Elipos47/robocup-2027-hand-on/hardware/README.md

# Hardware

Questa directory è riservata allo schema elettrico, cablaggi, misure e note di montaggio.

Non contiene ancora codice o file CAD. Il riferimento CAD esterno e le misure da eseguire sono
descritti in `docs/hardware/CAD_REFERENCE.md` e `docs/MEASUREMENT_LOG.md`.
