Elipos47/robocup-2027-hand-on/docs/hardware/checkerboard-a4.pdf

Checkerboard 9x6 corner interni, quadrato 25 mm - stampare al 100% 100 mm
