Elipos47/robocup-2027-hand-on/docs/hardware/Misure Robotica.pdf

INGOMBRI : la*lu*alt
Telecamera nera
Telecamera verde
Servo
Motori
Luci
Schermo
Batterie: 55x67x46

Arduino: 53x108x15 M3

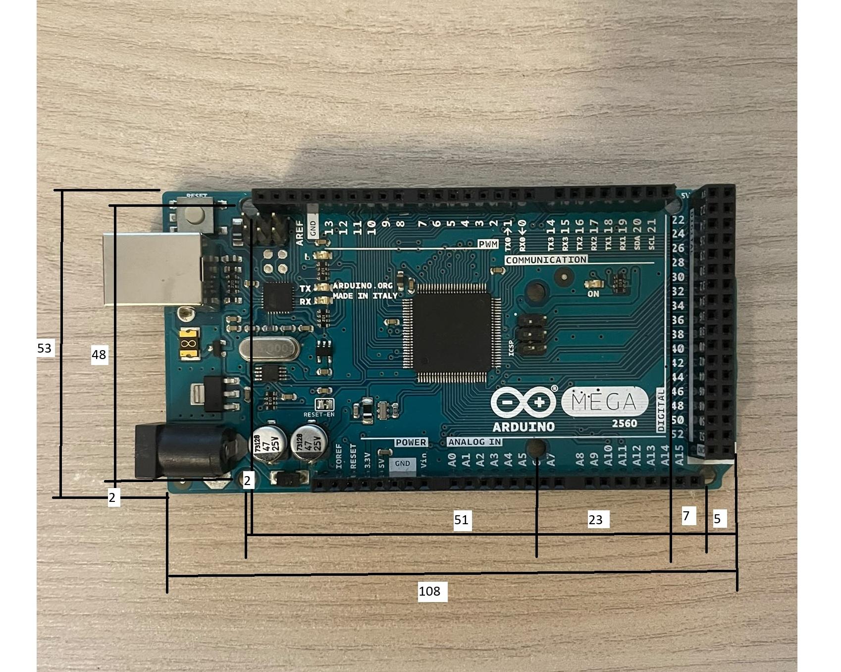
[picture p1: figure]

Raspberry :57x90x20 M3

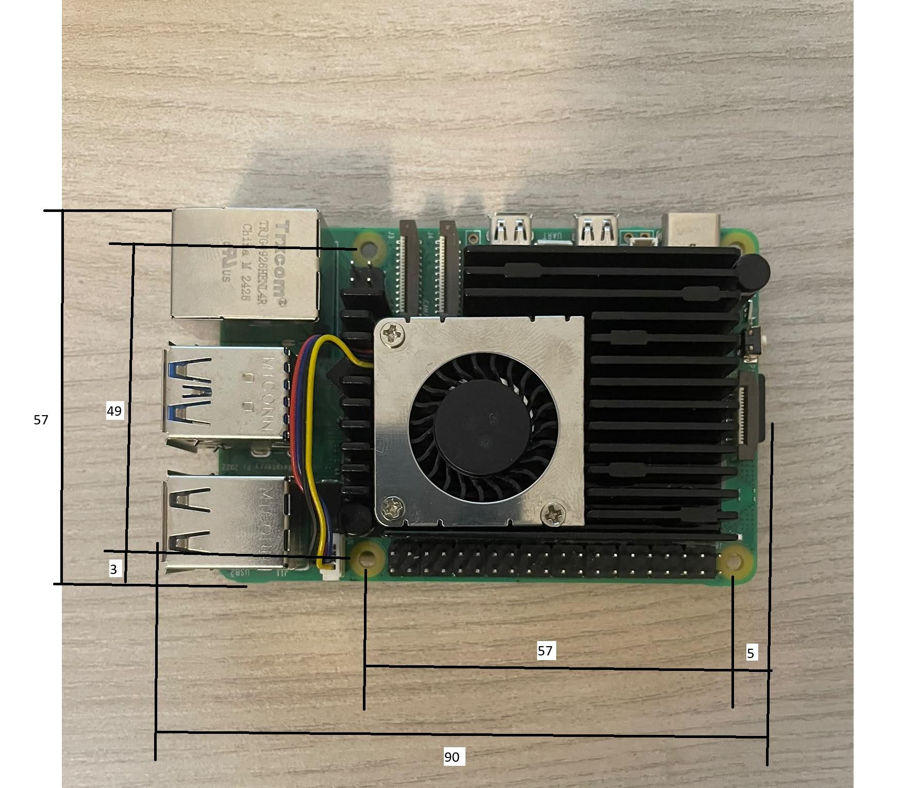
[picture p2: figure]

UPS: 71x90x35 M3

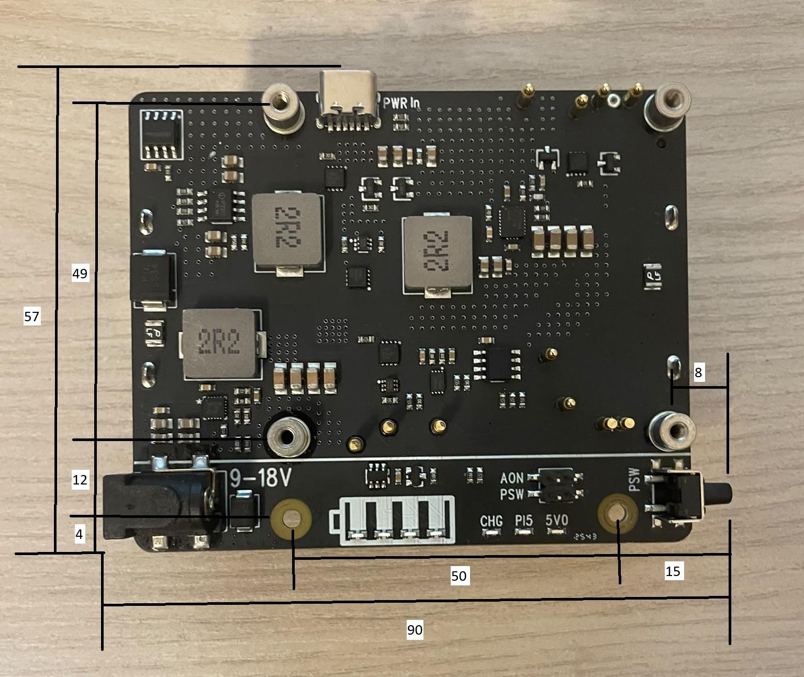
[picture p3: figure]

Sensore distanza: 6+20x45x15 M1

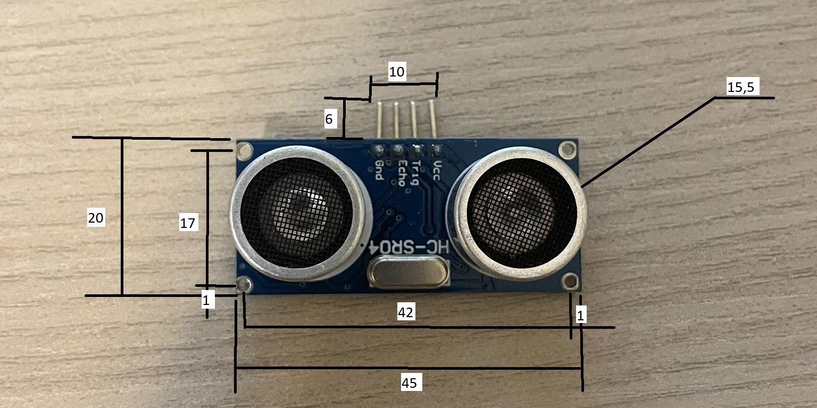
[picture p4: figure]

Giroscopio: 23x25x12 M2

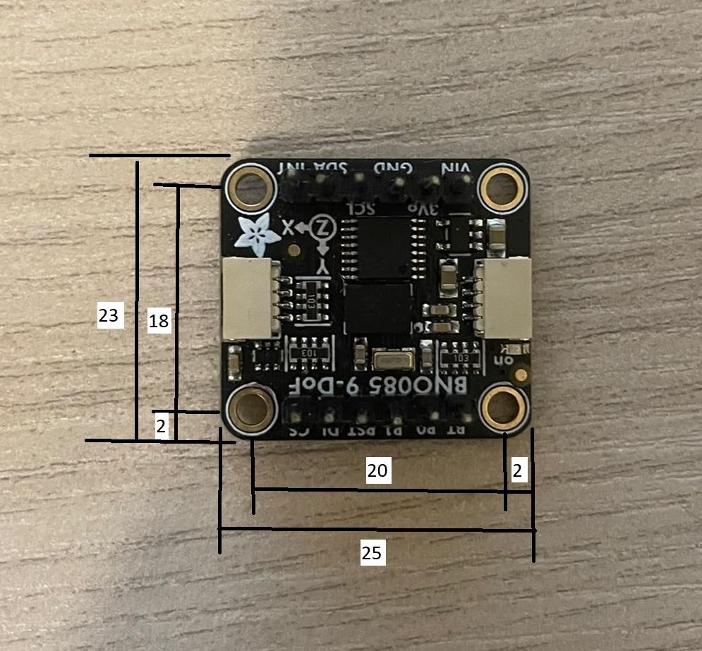
[picture p5: figure]
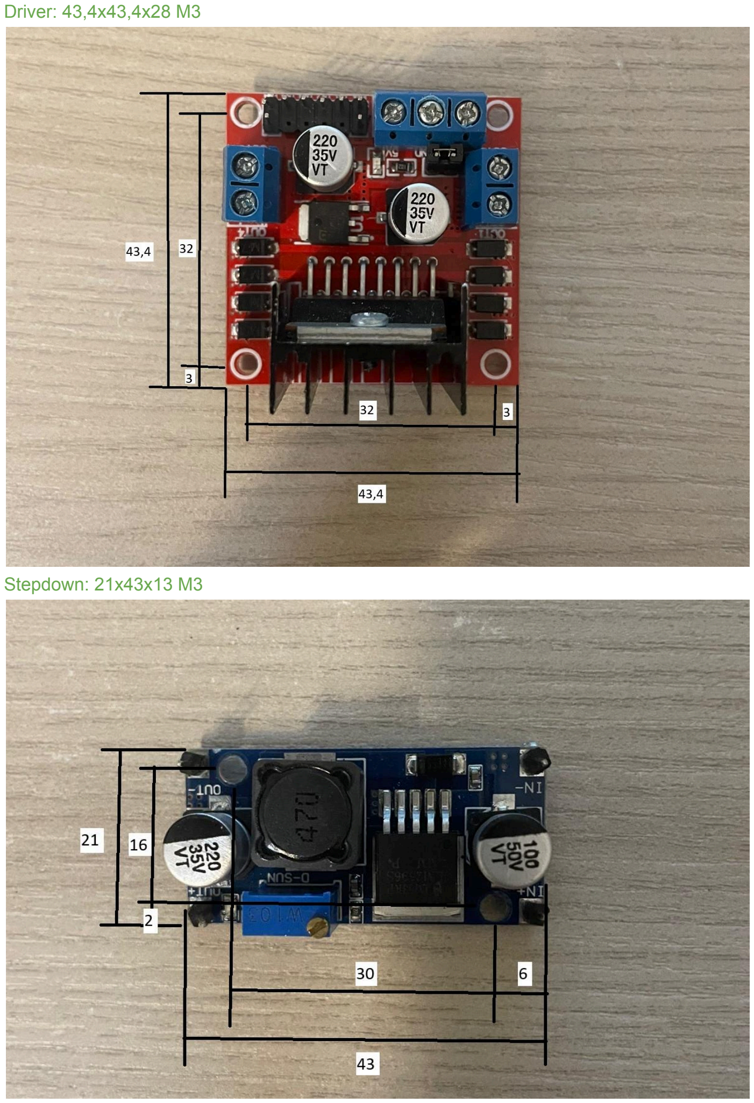
[picture p6: page 6]

Driver: 43,4x43,4x28 M3

Stepdown: 21x43x13 M3

FEATURE NECESSARIE/DA TENERE CONTO Maniglia
Interruttore
Cavo arduino
Cavo luci
Cavo telecamera verde
Cavo telecamera nera

COLLEGAMENTI
Telecamera nera = Raspberry Telecamera verde = Raspberry
UPS = Sotto raspberry
Raspberry = UPS+Arduino+Schermo Arduino = raspberry
Schermo = Raspberry
Servo = Arduino+Stepdown
Motori = L298
Luci = raspberry
Batterie = stepdown+L298
Giroscopio = arduino
Sensore distanza = Arduino Stepdown = batterie+servomotori L298 = Arduino+batterie
