Elipos47/robocup-2027-hand-on/docs/testing/MOTOR_POWER_DIAGNOSTIC.md

# Diagnosi alimentazione motori

**ID:** F0-5 / PWM-DIAG-1
**Data:** 2026-11-04
**Contesto:** due run del test a coppia 255
(`software/logs/pwm-pair-repeat-001.jsonl`, `software/logs/pwm-pair-repeat-002.jsonl`).
**Stato:** seconda run eseguita con multimetro; alimentazione stabile, misura A da solo 3 V e
A+B 0-1 V. Confronto con l'archivio fatto: mappa pin diversa, da verificare sul cablaggio
prima di cambiare i cavi.
**Obiettivo:** isolare la causa del guasto sotto carico prima di riprendere le misure di PWM
minimo e cm/s.

## Sintomo osservato

- prima fase avanti (255 su entrambe le ruote): entrambe le ruote girano;
- prima fase indietro (-255): la ruota destra non gira;
- fasi successive: entrambe le ruote fanno uno scatto iniziale e poi si fermano.

Il software ha accettato tutti i 6 comandi (`ack` 6-7 ms), lo status riporta `motors_active`
per tutta la durata e gli stop hanno ricevuto ack. Il firmware non ha segnalato errori o
watchdog. Il guasto e' quindi a valle dei pin del Mega: alimentazione, L298N, connettori o
motori.

## Risultati delle due run

| Run | Condizione | Esito fisico | Tensione +12/GND L298N |
|---|---|---|---|
| `pwm-pair-repeat-001` | robot appoggiato al tavolo, sotto carico | prima avanti ok, poi ruota destra ferma e scatti | non misurata |
| `pwm-pair-repeat-002` | ruote sollevate, multimetro DC | stesso guasto | stabile 10-12 V per tutta la prova |

La tensione stabile esclude batteria, BMS e caduta sul collegamento di alimentazione come causa
primaria. Restano il L298N (canale A o protezione termica), il motore destro e i connettori.
La prossima prova utile e' il test dei canali separati con misura di `OUT1`/`OUT2` e
`OUT3`/`OUT4` durante A avanti, A indietro, B avanti e B indietro, piu' la temperatura del
L298N.

## Misura con `pwm_staggered_test` (2026-11-04)

- A da solo a 255: **3 V** ai capi di `OUT1`/`OUT2`, motore A gira lentamente;
- A+B insieme: **0-1 V** ai capi di `OUT1`/`OUT2`, motore A fermo o solo scatto;
- multimetro in DC, puntali su `OUT1`/`OUT2`, ruote sollevate.

3 V sono troppo pochi: con alimentazione 10-12 V e la caduta tipica dell'L298N il motore
dovrebbe vedere circa 7-9 V. Il calo a 0-1 V quando si aggiunge B indica un limite condiviso:
alimentazione, massa o protezione termica. Poiche' `+12`/`GND` era stabile, i candidati
principali sono il **canale A del L298N** (caduta interna o protezione) e il **motore A**
(assorbimento anomalo per attrito o corto).

Misure successive, in ordine:

1. `5V` dell'Arduino rispetto a `GND`, a riposo e durante A da solo: atteso ~5 V;
2. `ENA` rispetto a `GND` durante A da solo: atteso ~5 V a 255;
3. temperatura del L298N dopo A da solo: se molto caldo, e' protezione termica;
4. scambio dei due connettori motore su `OUT1`/`OUT2` e `OUT3`/`OUT4`, a motori spenti e con
   approvazione: se il guasto segue il motore A e' il motore, se resta sul canale A e' l'L298N.

## Alimentazione motori assente (2026-11-05)

La batteria era collegata al morsetto `5V` del L298N invece che a `+12`. Il morsetto
`5V` e' l'uscita del 7805 (con jumper inserito) oppure l'ingresso del rail logico
(con jumper rimosso): non e' un ingresso di potenza. Con 11,1 V su quel morsetto il
rail logico e' fuori specifica (L298N `Vss` massimo 7 V) e i motori non avevano la
supply `Vs`. La lettura di 10-12 V su `+12` fatta in precedenza non dimostra che il
morsetto fosse alimentato: puo' essere la tensione di ritorno attraverso il 7805,
che sotto carico crolla. Le uscite OUT1=4 V, OUT2=0,8 V, OUT3=3 V, OUT4=0,6 V sono
coerenti con questo errore, non con due canali del ponte guasti. Il modulo non si e'
bruciato perche' la corrente era limitata dal percorso del 7805 e dal carico della
logica; resta fuori specifica e va considerato sospetto.

Da fare: ricollegare batteria `+` a `+12` e batteria `-` a `GND`, verificare il
jumper `5V`, controllare i rail 5 V di L298N, Arduino e Raspberry, poi ripetere
`pwm_a_forward_test` e misurare di nuovo.

## Ponte verificato a banco (2026-11-05)

Con `+12` alimentato e il `5V` del L298N collegato direttamente a `IN1` (bridge
chiuso a mano, senza PWM), il motore A gira. Quindi il 7805, il ponte e il motore
sono sani; il mancato movimento dopo il ricablaggio era un problema di connessioni
(segnale, GND o alimentazione logica). Resta da verificare il percorso
Arduino -> `ENA`/`IN1`/`IN2` con `pwm_a_forward_test` e la PWM.

## Confronto con il codice 2025-2026

| Progetto | EN destra (A) | IN destra (A) | EN sinistra (B) | IN sinistra (B) | Note |
|---|---:|---|---:|---|---|
| Attuale `firmware/rcj2027` | 12 (`ENA`) | 22/23 | 13 (`ENB`) | 24/25 | PWM su 12/13, IN digitali |
| Archivio `Final/robo_arduino` | 45 | 25/26 | 44 | 23/24 | commento nel sorgente: 22-27 non sono PWM, enable spostati su 44/45 |
| Archivio `nogyro/robo_arduino` | 27 | 25/26 | 22 | 23/24 | usa `analogWrite` anche su 22/27, che non sono PWM |
| Archivio `Arduino.ino` | jumper | 2/3 | jumper | 4/5 | nessun pin enable pilotato |

La legge di comando e' la stessa: due pin di direzione per canale, enable PWM, stop con
`EN=0` e `IN` bassi. La differenza e' la **mappa dei pin**. Se il robot e' ancora cablato come
l'anno scorso, il firmware attuale pilota pin diversi e i sintomi osservati (un motore che va,
l'altro no, scatti, tensione bassa) sono attesi.

Prima di cambiare i cavi, verificare a motori spenti con il multimetro in continuita':

- `ENA`/`ENB`: sono su 12/13, su 44/45 o su 22/27?
- `IN1`..`IN4`: sono su 22-25 o su 23-26?
- i jumper `ENA`/`ENB` sul L298N sono presenti o rimossi?
- il jumper `5V` del L298N e' inserito e il suo 5V e' collegato al 5V dell'Arduino?

Se il cablaggio corrisponde alla mappa attuale, la legge di comando e' equivalente a quella
dell'anno scorso e il sospetto torna su cavi, connettori, L298N o motore. Se non corrisponde,
non serve cambiare i cavi: vanno spostati sui pin del firmware attuale, oppure va cambiata la
mappa nel firmware.

## Caduta sui cavi e sui morsetti

Un cavo molto grosso in un morsetto piccolo puo' essere serrato solo su poche trecce: la
resistenza di contatto sale e sotto carico si perde tensione. Non e' il diametro in se', e' la
superficie di contatto.

Prova:

1. A da solo a 255 per 3-5 s, ruote sollevate.
2. Misurare la tensione sui morsetti `OUT1`/`OUT2` del L298N e ai capi del motore.
3. Se la differenza e' maggiore di 0,5 V a 1-2 A, il cavo o il morsetto e' il problema.
4. A motori spenti, controllare continuita' e resistenza del cavo; muovere il cavo per cercare
   un'intermittenza.
5. Dopo la prova, toccare i morsetti: un contatto caldo e' un contatto resistivo.

Rimedio: capocorda a tubetto o un pigtail di 1,0-1,5 mm² crimpato, con guaina termorestringente;
non saldare a stagno il cavo nel morsetto. Il cavo va dimensionato per la corrente, non per il
diametro massimo del morsetto.

## Ipotesi

| # | Ipotesi | Come discriminare |
|---:|---|---|
| 1 | batteria scarica o BMS che limita la corrente | tensione ai morsetti a riposo e durante il comando; se crolla o il BMS stacca, e' l'alimentazione |
| 2 | L298N in protezione termica o sovracorrente | temperatura del modulo e durata prima dell'arresto; se riparte dopo raffreddamento, e' il ponte |
| 3 | connettore o GND intermittente | prova a ruote sollevate muovendo delicatamente i connettori; cercare cavi caldi o contatti allentati |
| 4 | semiconduttore del canale A (ruota destra) danneggiato | A avanti/indietro da solo; misurare OUT1/OUT2 e scambiare i motori solo con approvazione |
| 5 | motore o riduttore destro bloccato | ruota girata a mano con alimentazione staccata; corrente a vuoto del solo motore |

## Procedura

**Sicurezza:** ruote sollevate e robot fissato per tutte le prove elettriche. Nessun test a
terra finche' la causa non e' isolata. Non cambiare cablaggi senza approvazione.

1. **Ispezione a motori spenti**
   - ruote girate a mano: devono girare libere;
   - connettori ENA/ENB, IN1..IN4, OUT1..OUT4 e GND ben inseriti;
   - nessun cavo caldo, spellato o connettore sciolto.

2. **Misure a riposo e sotto carico**
   - tensione batteria ai morsetti;
   - tensione +12 V e +5 V sul L298N;
   - tensione durante un comando a 255 (ruote sollevate);
   - temperatura del L298N prima e dopo 3 s a 255.
   Registrare i valori in `docs/MEASUREMENT_LOG.md`.

3. **Canali separati a ruote sollevate**
   - caricare `firmware/test/pwm_channel_test/`;
   - per misure ripetute con il multimetro usare `firmware/test/pwm_a_forward_test/`;
     tiene A avanti 255 per 5 s e fermo per 5 s, in loop, cosi' non serve
     premere reset a ogni lettura;
   - osservare A avanti, B avanti, A indietro, B indietro a 255;
   - se un solo verso del canale A fallisce, il sospetto e' il semiconduttore del ponte;
   - se tutti i canali funzionano da soli ma falliscono insieme, il sospetto e' la batteria o
     la corrente disponibile.

4. **Ripetizione a coppia con monitoraggio**
   - solo dopo i passi precedenti, ripetere 2-3 cicli a 255 con ruote sollevate;
   - misurare tensione e temperatura durante ogni ciclo;
   - se il guasto compare solo sotto carico, ripetere con la batteria carica e annotare la
     tensione.

5. **Scambio uscite motore (solo con approvazione)**
   - invertire i due connettori motore su OUT1/OUT2 e OUT3/OUT4;
   - se il guasto segue il motore, il problema e' nel motore o nei suoi fili;
   - se resta sul canale, il problema e' nel L298N.

## Criteri

- **PASS alimentazione:** tensione stabile sotto comando, senza stacco del BMS.
- **PASS ponte:** nessun spegnimento termico e tutti i canali ripetibili a 255.
- **PASS meccanica:** ruote libere e stesso comportamento avanti/indietro.
- Il test a coppia si considera chiuso solo con 3 ripetizioni consecutive a ruote sollevate,
  senza perdita di un canale.

## Dati da riportare

| Prova | Strumento | Valore | Condizione | Esito |
|---|---|---|---|---|
| Batteria a riposo |  |  |  |  |
| Batteria sotto comando 255 |  |  |  |  |
| L298N +12 V sotto comando |  |  |  |  |
| L298N +5 V |  |  |  |  |
| Temperatura L298N |  |  |  |  |
| A avanti/indietro |  |  | ruote sollevate |  |
| B avanti/indietro |  |  | ruote sollevate |  |
| Coppia 255, 3 cicli |  |  | ruote sollevate |  |
