Elipos47/robocup-2027-hand-on/docs/hardware/CALIBRATION.md

# Calibrazione manuale

Non esiste auto-calibrazione in runtime. Ogni camera e ogni sensore viene calibrato con una
procedura manuale, una condizione di luce registrata e un log salvato.

La calibrazione completa viene dopo il contratto minimo del software. Per iniziare servono solo
i parametri indicati in `docs/hardware/MINIMUM_HARDWARE_DATA.md`; le tarature dettagliate restano
differite.

## Strumenti software

La CLI `python3 -m rcj2027.diagnostics` (dalla cartella `software/`) supporta:

```sh
python3 -m rcj2027.diagnostics camera --list
python3 -m rcj2027.diagnostics camera --device auto --save /tmp/camera0.jpg
python3 -m rcj2027.diagnostics camera --csi --camera-num 0 --size 1280x720 \
  --full-fov --warmup 2 --save /tmp/csi0.jpg
python3 -m rcj2027.diagnostics camera --device auto --checkerboard 9x6
python3 -m rcj2027.diagnostics camera --csi --camera-num 0 --size 1280x720 \
  --full-fov --checkerboard 9x6
python3 -m rcj2027.diagnostics sonar --port /dev/ttyACM0 --duration 10 \
  --reference-mm 500 --reference-tolerance 50
python3 -m rcj2027.diagnostics imu --port /dev/ttyACM0 --duration 10 \
  --imu-mode motion --expected-axis yaw --countdown 5
python3 -m rcj2027.diagnostics camera-calibrate \
  --images "calib/*.jpg" --pattern 9x6 --square-mm 25 --output calib.json
python3 -m rcj2027.diagnostics checkerboard \
  --pattern 9x6 --square-mm 25 --output checkerboard.pdf
```

- `camera` misura luminosita', contrasto, nitidezza e, se richiesto, rileva il checkerboard;
  USB usa OpenCV, CSI usa Picamera2 con autofocus e warm-up;
- `sonar` confronta la media con una distanza misurata e controlla i salti;
- `imu` verifica rumore a riposo o movimento sull'asse atteso;
- `camera-calibrate` calcola matrice intrinseca e distorsione da almeno 3 immagini valide;
- `checkerboard` genera un PDF A4 con quadrati a dimensione fisica reale e barra da 100 mm.

I test software non sostituiscono la misura fisica: il lato del checkerboard, la distanza di
riferimento e l'orientamento degli assi vanno dichiarati dall'operatore.

## Calibrazione camera con checkerboard

1. Genera il target con `checkerboard` (default 9x6 corner interni, quadrati 25 mm). Il file
   pronto e' `docs/hardware/checkerboard-a4.pdf`; si puo' aprire con
   `xdg-open docs/hardware/checkerboard-a4.pdf` e rigenerare con il comando.
2. Stampa al 100% e verifica con un righello che la barra in basso sia lunga 100 mm. Se la barra
   misura 95 mm, la stampa e' al 95%: usa `--square-mm 23.75` (25 x 0.95) oppure ristampa senza
   scalatura. Il valore da passare e' sempre il lato **reale** del quadrato stampato.
3. Fissa il target su una superficie piana e opaca; cattura 12-20 immagini con la camera
  definitiva, a distanze e angolazioni diverse, con il pattern che occupa circa il 50-80% del
   frame. **Tutto il pattern e il bordo bianco devono essere dentro il frame**: se il bordo viene
   tagliato, `findChessboardCorners` restituisce 0 corner anche se a occhio vedi la scacchiera.
   Se il report dice `quality_passed: true` ma `checkerboard_corners: 0`, allontana il foglio o
   alza la camera. Evita riflessi, ombre e mosso. Con la USB:
   ```sh
   python3 -m rcj2027.diagnostics camera-capture --device auto \
     --count 15 --interval 2 --output-dir calib/usb
   ```
   Per la CSI usare `--csi --camera-num 0 --size 1280x720 --full-fov`; la calibrazione va fatta
   alla stessa risoluzione e con lo stesso campo visivo del pipeline della linea.
4. Salva le immagini in una cartella, ad esempio `calib/`.
5. Esegui `camera-calibrate` con lo stesso pattern e lato usati per la stampa.
6. Il calibratore rifiuta se il pattern occupa in media meno del **20%** del frame. Punta al
   50-80%: avvicina la camera o usa un target piu' grande. Se sei vincolato dalla quota, con
   **pose diverse** puoi accettare 14-20% usando `--min-coverage 0.14`. Il calibratore rifiuta
   anche viste quasi identiche: inclina e sposta il target tra i frame
   (`--min-pose-spread`, default 40 px).
7. Conserva il JSON prodotto e verifica l'RMS: sotto 1 px e' accettabile, sotto 0,5 px e' buono.

La calibrazione reale usa la lente e il montaggio veri; le viste sintetiche verificano solo il
codice. Una camera sfocata o un target storto producono un RMS alto e non vanno usati.

Calibrazione USB accettata il 2026-11-01: 15 viste, RMS 0,523 px, copertura media 22,7%, lato
reale 23,75 mm. Il JSON e' in `software/rcj2027/calibrations/usb_640x480.json`.

## Assi IMU

Il BNO085 riporta tre rotazioni rispetto ai propri assi:

- **yaw**: rotazione attorno all'asse verticale, cioe' il cambio di direzione;
- **pitch**: rotazione attorno all'asse trasversale, cioe' muso su/giu';
- **roll**: rotazione attorno all'asse longitudinale, cioe' inclinazione destro/sinistro.

Sul montaggio attuale pitch e roll sono scambiati rispetto al telaio: il firmware li scambia con
`IMU_SWAP_PITCH_ROLL=true`. Dopo un rimontaggio del BNO085 riesegui i tre test.

Per verificare l'allineamento al telaio, esegui un test per asse:

```sh
python3 -m rcj2027.diagnostics imu --port /dev/ttyACM0 --duration 10 \
  --imu-mode motion --expected-axis yaw --countdown 5
python3 -m rcj2027.diagnostics imu --port /dev/ttyACM0 --duration 10 \
  --imu-mode motion --expected-axis pitch --countdown 5
python3 -m rcj2027.diagnostics imu --port /dev/ttyACM0 --duration 10 \
  --imu-mode motion --expected-axis roll --countdown 5
```

Ruota il robot attorno all'asse indicato, senza spostarlo. Il report mostra l'asse dominante,
l'escursione e la deriva. Se l'asse dominante non coincide con quello atteso, il montaggio o la
convenzione degli assi vanno corretti nel software.

## Distanza del sonar

Per il test di riferimento usa un bersaglio piano e rigido, perpendicolare al sensore:

- **500 mm** come primo punto, con un bersaglio di almeno 20x20 cm;
- **1000 mm** come secondo punto, con un bersaglio di almeno 30x30 cm.

Misura la distanza dalla faccia del sensore alla faccia del bersaglio con un metro. Lascia almeno
1,5 m liberi dietro il bersaglio e togli oggetti laterali che possano riflettere. La tolleranza
iniziale e' ±50 mm. Se il test mostra salti verso distanze molto diverse, il problema e' il
bersaglio o l'ambiente, non la formula del firmware.

```sh
python3 -m rcj2027.diagnostics sonar --port /dev/ttyACM0 --duration 10 \
  --reference-mm 500 --reference-tolerance 50
```

Ripeti a 1000 mm e registra media, deviazione standard e salto massimo.

## Camera linea

La camera linea e' la **CSI IMX708**. Va calibrata alla risoluzione di lavoro (ad esempio
1280x720 o 1536x864), non a 640x480: la calibrazione e' legata alla risoluzione. Verificare prima
messa a fuoco e montaggio; poi:

1. Fissare la camera nella posizione definitiva.
2. Registrare altezza, inclinazione, focale e distanza dal suolo.
3. Catturare una superficie bianca e una linea nera con luce nota.
4. Salvare i range HSV/ROI e la procedura usata.
5. Ripetere con luce debole, luce forte e ombre.

## Camera vittime

La camera stanza/vittime e' la **USB 5MP**. La calibrazione 640x480 accettata e' in
`software/rcj2027/calibrations/usb_640x480.json`; se si usa una risoluzione diversa va rifatta.

- fotografare la posizione della camera;
- misurare distanza e angolo di visione della stanza;
- definire una procedura di calibrazione solo dopo aver verificato il montaggio;
- non usare un modello o una soglia importati senza dati reali.

## Regole

- salvare data, condizione, valori e modifiche hardware;
- non dichiarare una calibrazione valida se i test sul campo peggiorano;
- non inserire immagini o dati sensibili non necessari nel repository.
