Elipos47/robocup-2027-hand-on/docs/hardware/BRINGUP_CHECKLIST.md

# Checklist di bring-up hardware

Usare in ordine, con alimentazione controllata e un operatore che possa fermare il robot.
Questa checklist e' il gate di sicurezza prima del movimento reale; non e' un prerequisito per
scrivere il contratto software o per lo scaffolding del logger.

- [ ] Fotografare il montaggio completo e i connettori.
- [ ] Verificare batterie, tensione, polarità e protezioni.
- [ ] Verificare massa, stabilita' e centro di massa.
- [ ] Collegare Raspberry e Arduino con alimentazione e messa a terra definite.
- [ ] Testare comunicazione senza motori collegati.
- [ ] Verificare camera, sonar e IMU con `python3 -m rcj2027.diagnostics`.
- [ ] Verificare heartbeat, stop e watchdog.
- [ ] Collegare un motore alla volta con ruote sollevate.
- [ ] Verificare verso, freno e limite PWM.
- [ ] Collegare IMU, sonar e servo solo dopo il safety test.
- [ ] Eseguire il primo test sul campo con batteria annotata.
- [ ] Registrare ogni esito nel `MEASUREMENT_LOG.md` e nel report della run.
