Elipos47/robocup-2027-hand-on/(commit log)

2026-10-21 fix: rendi portabile il controllo dei sorgenti in check_context.sh
2026-10-31 docs: registra la mappa pin L298N fornita (ENA/ENB 12/13, IN1-4 22-25)
2026-10-31 docs: registra i pin HC-SR04 e l'assenza dei jumper ENA/ENB
2026-10-31 docs: registra il collegamento I2C del BNO085 su SDA 20 e SCL 21
2026-10-31 docs: conferma il breakout Adafruit BNO085 compatibile con I2C a 5 V
2026-10-31 feat: avvia la fase di sviluppo codice e integra il test motori
2026-10-31 test: mantieni i motori accesi fino allo stop manuale
2026-10-31 test: adatta il PWM ai motori RS PRO 834-7631 (4.5-15 V)
2026-10-31 test: inverte la polarita dei motori e registra il modello RS PRO
2026-10-31 docs: registra la verifica della polarita dei motori
2026-10-31 docs: completa il contratto minimo con la mappa A=destra, B=sinistra
2026-10-31 feat: implementa il firmware Arduino del protocollo v1.1
2026-10-31 feat: aggiunge la console seriale interattiva con payload minuscoli
2026-10-31 test: verifica a banco il protocollo v1.1 senza movimento (P1)
2026-10-31 test: ripete B0 a PWM 255 e registra lo spunto insufficiente a 150
2026-10-31 test: conferma la rotazione a PWM 255 e chiude il nucleo di B0
2026-10-31 feat: integra la sessione seriale B1 con handshake, heartbeat e log
    - aggiunge RobotSession con handshake, heartbeat, status, stop e link
    - bufferizza le righe seriali parziali e scarta i frame pre-handshake
    - estende la CLI con --duration e il riepilogo di sessione
    - aggiunge i test host della sessione e il report B1-1
2026-10-31 feat: aggiunge il gate software per i comandi motori B1-2
    - drive() richiede il gate di sicurezza e limita i valori a pwm_max
    - attende l'ack continuando gli heartbeat e invia X su rifiuto o timeout
    - aggiunge i test host del comando motori e la procedura B1-2
    - nessun comando D reale inviato: la prova richiede ruote sollevate
2026-10-31 test: esegue B1-2 e corregge l'attesa ack con backlog di status
    - verifica D a 255 su entrambe le ruote e canali separati, con rotazione confermata
    - drena status fino alla deadline in _wait_for_ack e stop
    - aggiunge test di regressione con 20 status in coda
    - registra misure B1-2 e ripristina il firmware sicuro
2026-10-31 feat: legge HC-SR04 e BNO085 e fissa i valori operativi
    - aggiunge la lettura non bloccante del sonar e il game rotation vector BNO085
    - ritenta l'inizializzazione IMU al boot e riporta i bit 0/1 nello status
    - aggiunge OPERATIONAL_CONFIG con pwm_max=255 e watchdog 1.0 s
    - mantiene DEFAULT_CONFIG chiuso e il firmware sicuro
    - documenta B1-3 e aggiunge lo scanner I2C di banco
2026-10-31 feat: aggiunge la diagnostica software di camera, sonar e IMU
    - analizza validita', stabilita', riferimento sonar e asse IMU atteso
    - aggiunge probe camera, metriche frame e calibrazione checkerboard
    - espone la CLI diagnostics con report JSON ed exit code
    - documenta i risultati reali: camera e IMU passano, sonar instabile
    - aggiunge 38 test host, porta la suite a 123
2026-10-31 feat: supporta la telecamera CSI IMX708 nella diagnostica
    - aggiunge probe Picamera2/libcamera con autofocus e warm-up
    - elenca le camere libcamera oltre agli indici OpenCV
    - aggiunge --csi alla CLI e il modello al report
    - documenta CSI acquisita ma sfocata (sharpness 9.3)
2026-10-31 feat: aggiunge il target checkerboard e le procedure di calibrazione
    - genera un PDF A4 con quadrati da 25 mm e barra di scala da 100 mm
    - documenta calibrazione camera, assi IMU e distanza sonar 500/1000 mm
    - aggiunge i test del generatore checkerboard
    - porta la suite a 129 test
2026-10-31 fix: scambia pitch e roll dell'IMU per il montaggio
    - aggiunge IMU_SWAP_PITCH_ROLL per correggere gli assi fisici
    - verifica pitch e roll con asse dominante corretto
    - registra le misure after-swap e aggiorna la documentazione
    - la convenzione dei segni resta da validare
    [rcj2027.ino]
2026-10-31 test: registra il test sonar a 500 mm fallito
    - media 597.6 mm ed errore +97.6 mm rispetto al riferimento
    - probabile misura dal telaio invece che dalla faccia del sensore
    - il test resta FAIL finche' non viene ripetuto con distanza corretta
2026-10-31 fix: usa la mediana per il riferimento sonar
    - la media era trascinata dagli outlier a 1100 mm
    - il riferimento ora usa la mediana e riporta anche la media
    - aggiunge un test con tre campioni a 400 e uno a 1100
    - aggiorna i risultati del test a 500 mm
    [sensor_checks.py]
2026-10-31 test: registra il quarto tentativo sonar a 500 mm
    - mediana 598 mm ed errore +98 mm
    - il target appare a circa 600 mm, non 500
    - restano salti a ~1100 mm; test FAIL
2026-10-31 fix: usa mediana e outlier per il test sonar
    - il riferimento usa la mediana, robusta agli echi spuri
    - il pass ammette al massimo il 5% di outlier oltre 200 mm
    - il salto massimo resta nel report ma non decide da solo
    - con target fermo a ~500 mm le run 005/006 passano
    [diagnostics.py, sensor_checks.py]
2026-10-31 feat: aggiunge camera-capture e il target checkerboard A4
    - salva una sequenza di frame USB o CSI per la calibrazione
    - include il PDF A4 pronto in docs/hardware/checkerboard-a4.pdf
    - accetta il test sonar a 500 mm per ostacoli vicini
    - porta la suite a 134 test
2026-10-31 docs: compensa la scala di stampa del checkerboard
    - se la barra misura 95 mm, il lato reale e' 23.75 mm
    - documenta la correzione e la aggiunge al report del target
2026-10-31 fix: rifiuta calibrazioni con target troppo piccolo
    - controlla la copertura media del checkerboard, minimo 20%
    - le 15 foto attuali coprono 7.2% e vengono rifiutate
    - documenta il valore reale 23.75 mm per la stampa al 95%
    - ignora le catture locali in software/calib/
    [camera_calibration.py, diagnostics.py]
2026-10-31 test: registra il secondo set di calibrazione rifiutato
    - 8/15 frame rilevati, copertura media 11.0%
    - solo 3 viste sopra il 20%, distanza incoerente
    - servono viste a distanza fissa con target grande
2026-11-01 fix: rileva automaticamente la telecamera USB
    - la numerazione /dev/videoN cambia al riavvio
    - --device auto trova la USB tramite sysfs
    - evita di aprire il nodo CSI come se fosse la USB
    - aggiunge i test del rilevamento e porta la suite a 138
    [camera_checks.py, diagnostics.py]
2026-11-01 test: accetta e versiona la calibrazione USB
    - 15/15 immagini, RMS 0.523 px, copertura 22.7%
    - salva il JSON in software/rcj2027/calibrations/usb_640x480.json
    - aggiunge un test di coerenza del file versionato
    - porta la suite a 139 test
2026-11-01 feat: assegna USB alla stanza e CSI alla linea
    - conferma i ruoli delle telecamere
    - aggiunge --size per la CSI e normalizza la nitidezza a 640 px
    - verifica CSI 1280x720 con nitidezza 149.3
    - la calibrazione USB resta valida per la stanza a 640x480
2026-11-01 fix: distingue qualita' frame e checkerboard trovato
    - aggiunge quality_passed al report camera
    - spiega che un checkerboard tagliato da' 0 corner anche se e' visibile a occhio
    - documenta che serve tutto il bordo bianco nel frame
    [camera_checks.py]
2026-11-01 fix: avvisa quando il checkerboard e' tagliato
    - quality_passed vero e corner zero ora produce un avviso esplicito
    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
    [diagnostics.py]
2026-11-01 feat: aggiunge --full-fov per la CSI linea
    - 1280x720 usa di default il crop 1536x864
    - --full-fov forza il sensore intero 2304x1296
    - con checkerboard completo la probe da' 54 corner e passed
    - documenta la differenza tra preview e still
2026-11-01 fix: rifiuta calibrazioni con viste troppo simili
    - controlla dispersione dei centri e variazione di dimensione
    - 15 frame CSI identici vengono rifiutati con un errore chiaro
    - documenta che 8-10 pose diverse sono meglio di 15 copie
    - con pose varie si puo' usare --min-coverage 0.14
    [camera_calibration.py, diagnostics.py]
2026-11-01 test: accetta e versiona la calibrazione CSI
    - 14/15 viste, RMS 0.542 px, copertura 16.3%
    - pose spread 423.6 px e size ratio 1.93
    - salva il JSON in software/rcj2027/calibrations/csi_1280x720.json
    - aggiunge il test del file versionato e porta la suite a 145
2026-11-01 feat: aggiunge il pipeline visione linea F0
    Implementa undistort CSI, rilevamento della linea con scanline e fit robusto, confidenza, tracker, CLI line/line-undistort e test host. Aggiunge il report F0-1 e aggiorna la documentazione di stato.
2026-11-01 fix: stabilizza il rilevamento linea e valida F0-1
    Scansione top-down con stop dopo un gap, continuita' di larghezza, soglia scura a 140 e offset sull'ultima riga valida. Aggiunge il test sintetico del bordo tavolo e aggiorna il report F0-1 con la prova reale: 30/30 frame, offset stabile, heading ~4 gradi, confidenza 0,95.
    [diagnostics.py, line_vision.py]
2026-11-01 feat: aggiunge il loop live della linea F0
    Elabora la CSI in configurazione video 1280x720 full-fov con calibrazione, tracker e log JSONL, senza comandi ai motori. Prima prova: 100 frame in 5,03 s (19,9 FPS), 100/100 trovati, offset -46,5 px, heading 4,17 deg. Aggiunge il parser line-live e il test del comando line-undistort.
2026-11-01 docs: allinea i risultati del loop live F0-2
    Usa la run archiviata in software/logs/f0-live-001: 100 frame in 5,04 s, 19,8 FPS, offset -46,52 px, heading 4,14 deg, confidenza 0,955.
2026-11-01 feat: aggiunge la vista live della telecamera
    Aggiunge --preview (finestra OpenCV) e --http-port (stream MJPEG per browser locale) a line-live, con frame annotato, log e riepilogo. Verificati 18 frame in 1 s in preview e stream MJPEG valido; 182 test verdi.
2026-11-01 feat: rende la live interattiva e pronta per Thonny
    Aggiunge --duration 0 fino a q/ESC, pulsante di stop nello stream, --debug-overlay con maschera, ROI arancione, stop pulito via SIGINT e script software/line_live.py da aprire in Thonny. 183 test verdi.
2026-11-03 docs: aggiunge il protocollo F0-2/3/4
    Definisce setup, misure e criteri provvisori per curva, ombra e gap, con l'uso di line-live e la distinzione tra perdita/ripresa F0 e attraversamento F1.
2026-11-03 feat: misura l'avvio live e analizza F0-2
    Aggiunge camera_start_s, warmup_s e first_frame_s al report line-live. Documenta la prima run sulla curva: rilevamento corretto nei tratti in ROI, ma 317 frame iniziali vuoti e 223 di riposizionamento; F0-2 resta aperto. Il ritardo di 18.7 s della run e' anomalo rispetto ai 2.1-2.2 s misurati.
2026-11-03 docs: corregge il criterio F0-2 per la ROI near-field
    La curva puo' uscire dalla ROI: il test valuta i tratti in cui la linea e' visibile, l'assenza di falsi e la ripresa, senza raggio fisico ne' linea 1-2 cm. Il nastro disponibile e' un proxy di banco; F0-2 e' coperto sul banco.
2026-11-03 docs: registra l'ombra parziale F0-3
    Primo tentativo: 608/608 frame trovati, 0 perdite, confidenza 0.663-0.978; l'ombra era probabilmente leggera. Chiarisce la differenza tra ombra parziale, ombra totale e occlusione e aggiorna lo stato.
2026-11-03 fix: rifiuta i bordi sottili in bassa luce
    Aggiunge la continuita' di larghezza al tracker: un restringimento brusco non viene confermato. Nel replay della run ombra totale 765 trovati diventano 433 accettati, 332 rifiutati e 426 confermati; control_passed=false. Aggiunge tracked_found, width_rejected_frames e confirmed_ratio al report live. 186 test verdi.
    [diagnostics.py, line_vision.py]
2026-11-03 fix: migliora l'aggancio della linea dopo il gap
    Registra la run gap da 7 cm: FOUND sui segmenti, LOST nel vuoto, 6 riprese. Corregge lo stop sul gap (solo dopo min_valid_rows) e il filtro di larghezza (aumento ammesso), con test sintetico del disturbo isolato. 187 test verdi.
    [line_vision.py]
2026-11-03 fix: scarta i semi corti che bloccano la linea
    Nella seconda run gap un seme isolato lontano impediva di agganciare il segmento vero. Se il tratto e' piu' corto di min_valid_rows, viene scartato e la scansione riparte dal candidato piu' centrale. Aggiunto il test far_speck. 188 test verdi.
    [line_vision.py]
2026-11-03 test: chiude F0-4 sul banco con il gap da 7 cm
    Terza run 182854 con il reset del seme: 487 frame, 284/487 trovati, 304 confermati, 6 riprese, frame 120 FOUND. FOUND sui segmenti, LOST nel vuoto, nessun falso. L'attraversamento del gap resta F1.
2026-11-03 feat: aggiunge il controller dry-run F0-5
    line_control.py produce FOLLOW/STOP da TrackState senza seriale; line-control fa replay dei log e scrive i comandi proposti. Replay: retta 98/100, curva 872/1584, gap 270/487, ombra parziale 578/608, ombra totale 416/900; comandi entro 0..255 e motor_output=false. 199 test verdi.
2026-11-03 test: registra lo sweep PWM senza rotazione
    Aggiunge pwm_sweep.py con conferma ruote sollevate e stop tra i gradini. Sweep 150-255: D accettati, motors_active=true, 0 errori, stop ack, ma nessuna rotazione. Il percorso software arriva ai pin; causa da isolare su alimentazione/enable/L298N. Firmware sicuro ripristinato.
    [pwm_sweep.py]
2026-11-03 test: aggiunge lo sketch PWM su entrambi i canali
    Sketch automatico a ruote sollevate: avanti entrambi a 255 per 4 s, stop, indietro per 4 s, due cicli. Compilato ma non caricato; dopo il test va ripristinato il firmware sicuro.
2026-11-03 test: aggiunge lo sketch per i canali PWM separati
    Registra il risultato del test a due canali: ruota sinistra attiva, destra ferma. Aggiunge pwm_channel_test per provare A e B separatamente a 255 e isolare canale A/motore destro. Compilato, non caricato.
2026-11-03 test: aggiunge lo sketch PWM con avvio scaglionato
    I canali A e B funzionano separatamente; insieme il destro non parte. Lo sketch scaglionato avvia A poi B e viceversa per distinguere alimentazione/corrente da canale/motore. Compilato, non caricato.
2026-11-03 docs: chiude la sessione PWM con entrambi i motori attivi
    Dopo il controllo dei collegamenti entrambi i motori funzionano singolarmente e in coppia a 255; il guasto precedente non si e' ripetuto e la causa non e' identificata. Resta un rischio di affidabilita': ripetere il test e controllare i serraggi. Firmware sicuro ripristinato; prossimo passo misura PWM/cm/s.
2026-11-04 test: registra il guasto a coppia 255 sotto carico
2026-11-04 docs: sospende la diagnosi motori in attesa del multimetro
2026-11-04 docs: registra la seconda run a coppia con multimetro
2026-11-04 feat: aggiunge il test PWM a canale singolo
2026-11-04 docs: confronta la mappa pin motori con l'archivio 2025-2026
2026-11-04 docs: aggiunge la prova di caduta su cavi e morsetti
2026-11-05 feat: aggiunge il test A avanti in loop
2026-11-05 docs: registra la batteria sul 5V del L298N
2026-11-05 docs: chiude la diagnosi del ponte L298N
